MRGdSFS/PI4-ICA-IoT/outputs/renders/sit_hero.png

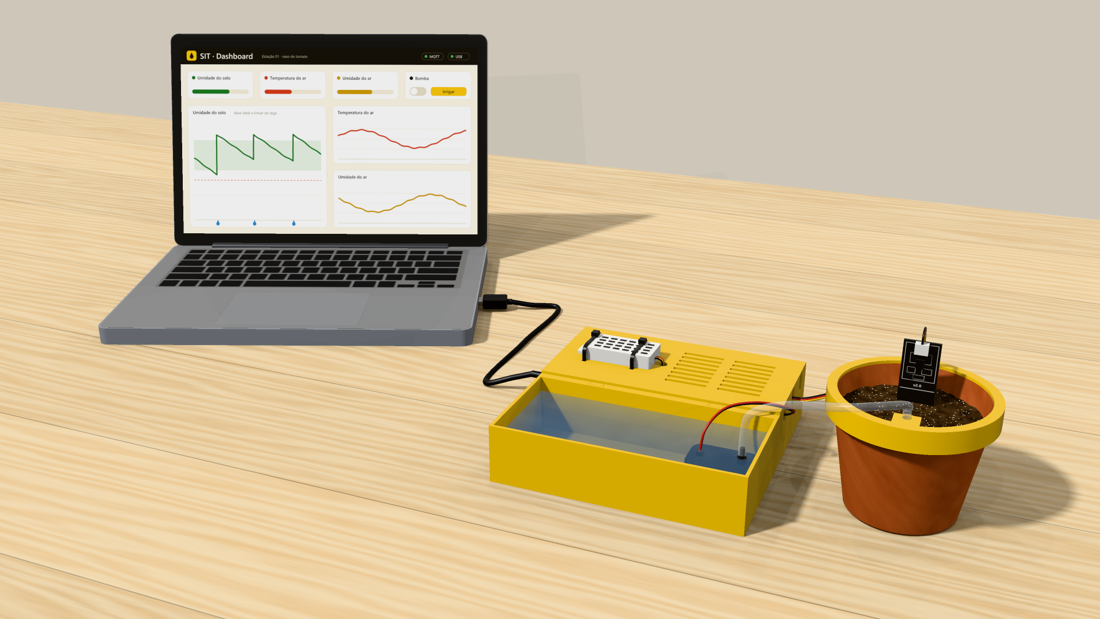
outputs/renders/sit_hero.png
