MRGdSFS/PI4-ICA-IoT/outputs/renders/sit_sobre_notebook.png

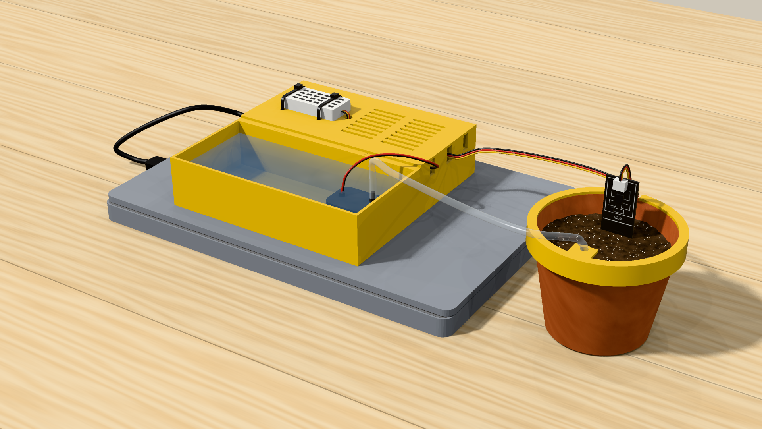
outputs/renders/sit_sobre_notebook.png
