MRGdSFS/PI4-ICA-IoT/codes/modelo3d/render/tex/dashboard.png

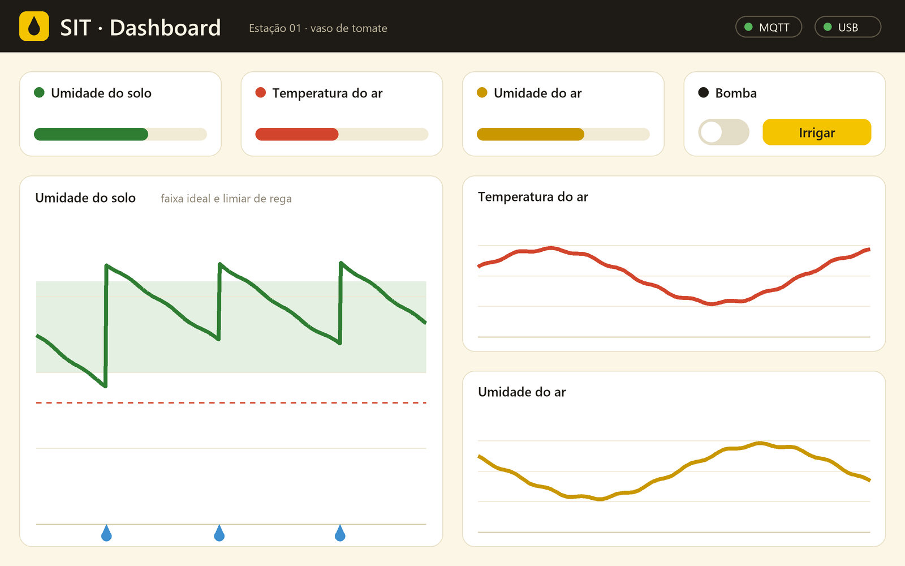
codes/modelo3d/render/tex/dashboard.png
