MRGdSFS/PI4-ICA-IoT/codes/modelo3d/render/tex/esp32_pcb.png

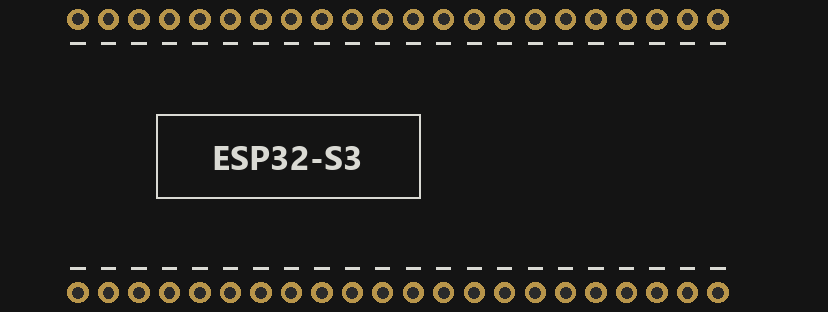
codes/modelo3d/render/tex/esp32_pcb.png
