MRGdSFS/PI4-ICA-IoT/codes/modelo3d/render/tex/protoboard.png

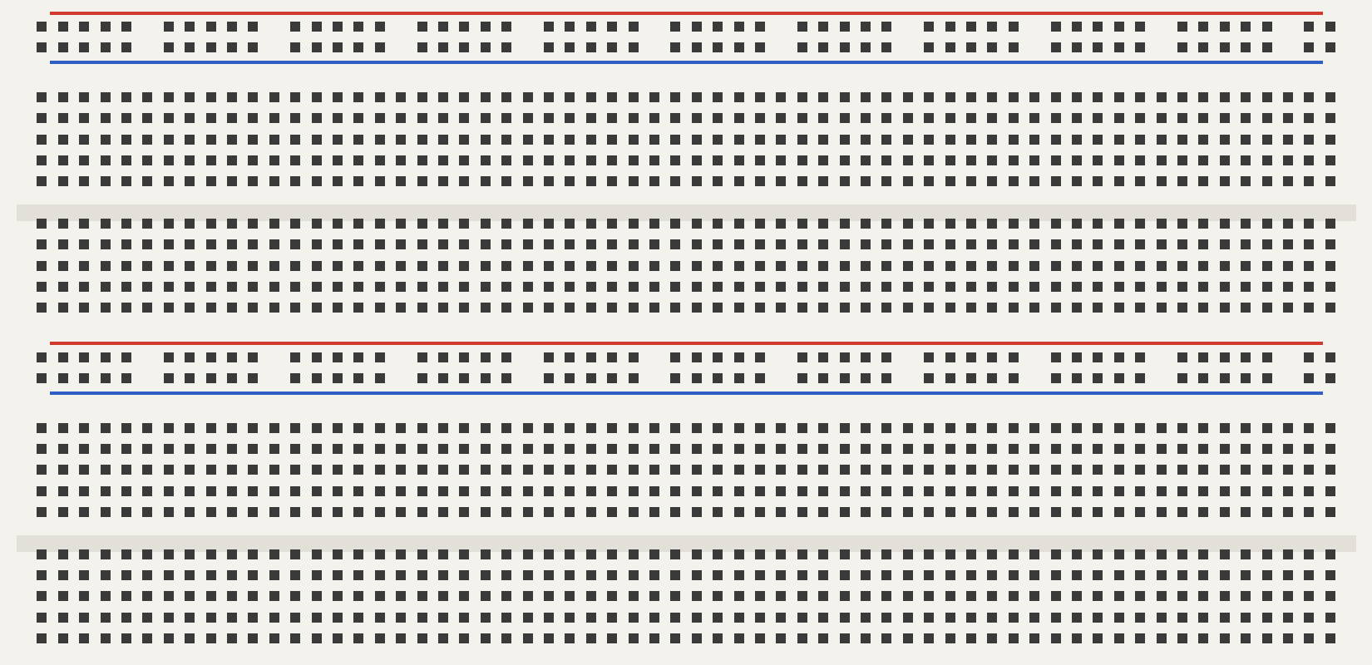
codes/modelo3d/render/tex/protoboard.png
