MRGdSFS/PI4-ICA-IoT/codes/modelo3d/render/tex/sensor_pcb.png

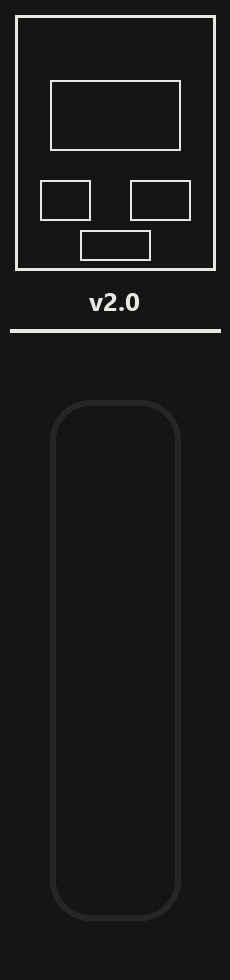
codes/modelo3d/render/tex/sensor_pcb.png
