MRGdSFS/PI4-ICA-IoT/codes/modelo3d/render/tex/teclado.png

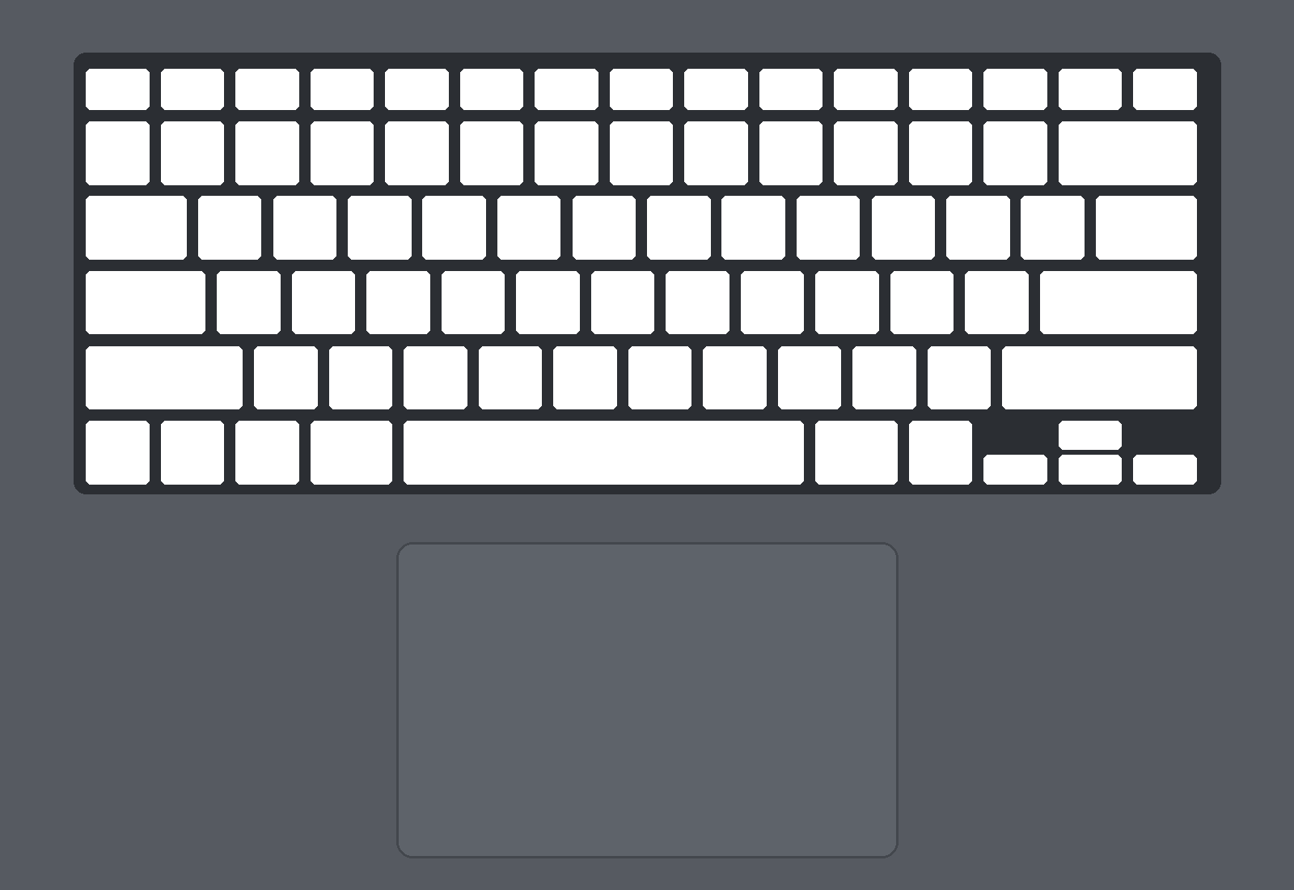
codes/modelo3d/render/tex/teclado.png
