MRGdSFS/PI4-ICA-IoT/outputs/coleta/comunicacao.png

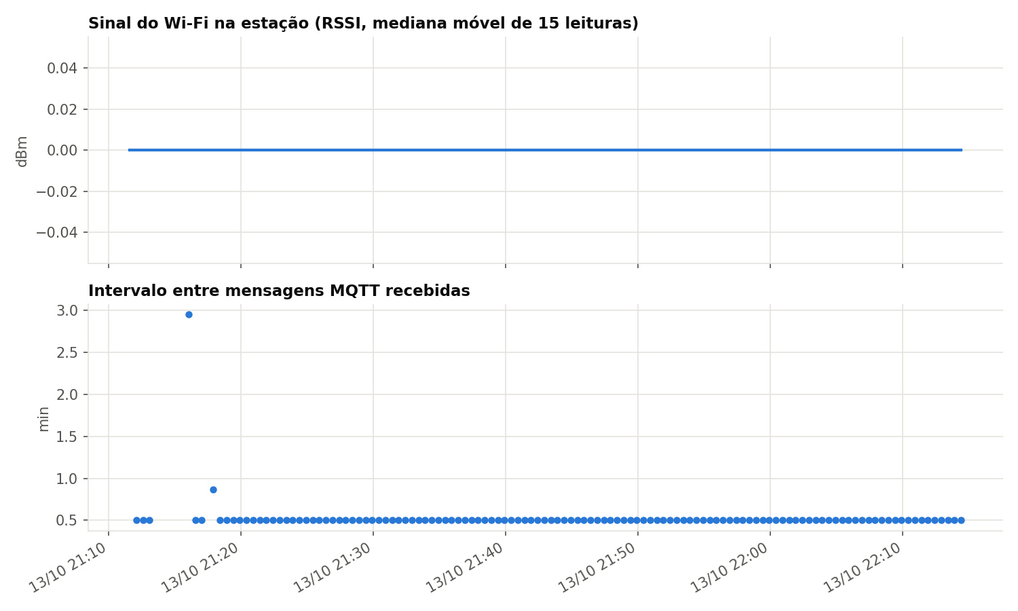
outputs/coleta/comunicacao.png
