MRGdSFS/PI4-ICA-IoT/outputs/coleta/serie_temporal.png

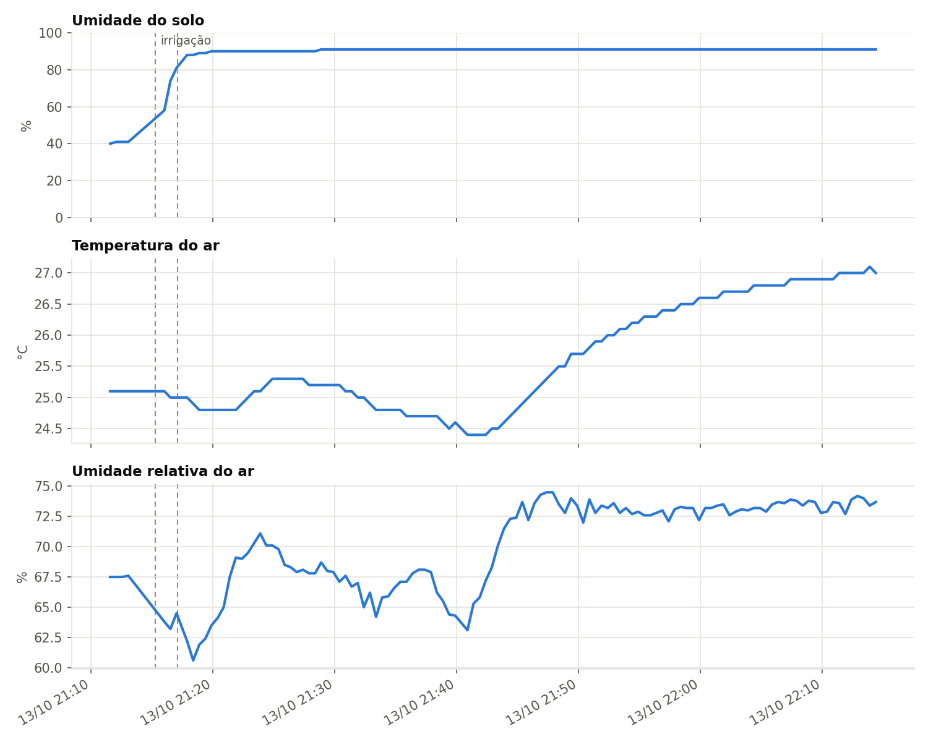
outputs/coleta/serie_temporal.png
