MRGdSFS/PI4-ICA-IoT/outputs/eda02/05_umidade_solo_linha_1_sensor_0fa420b6626076658c3c1763550aee8149c2be5dba876a84a1ebd24aeaa84a78.png

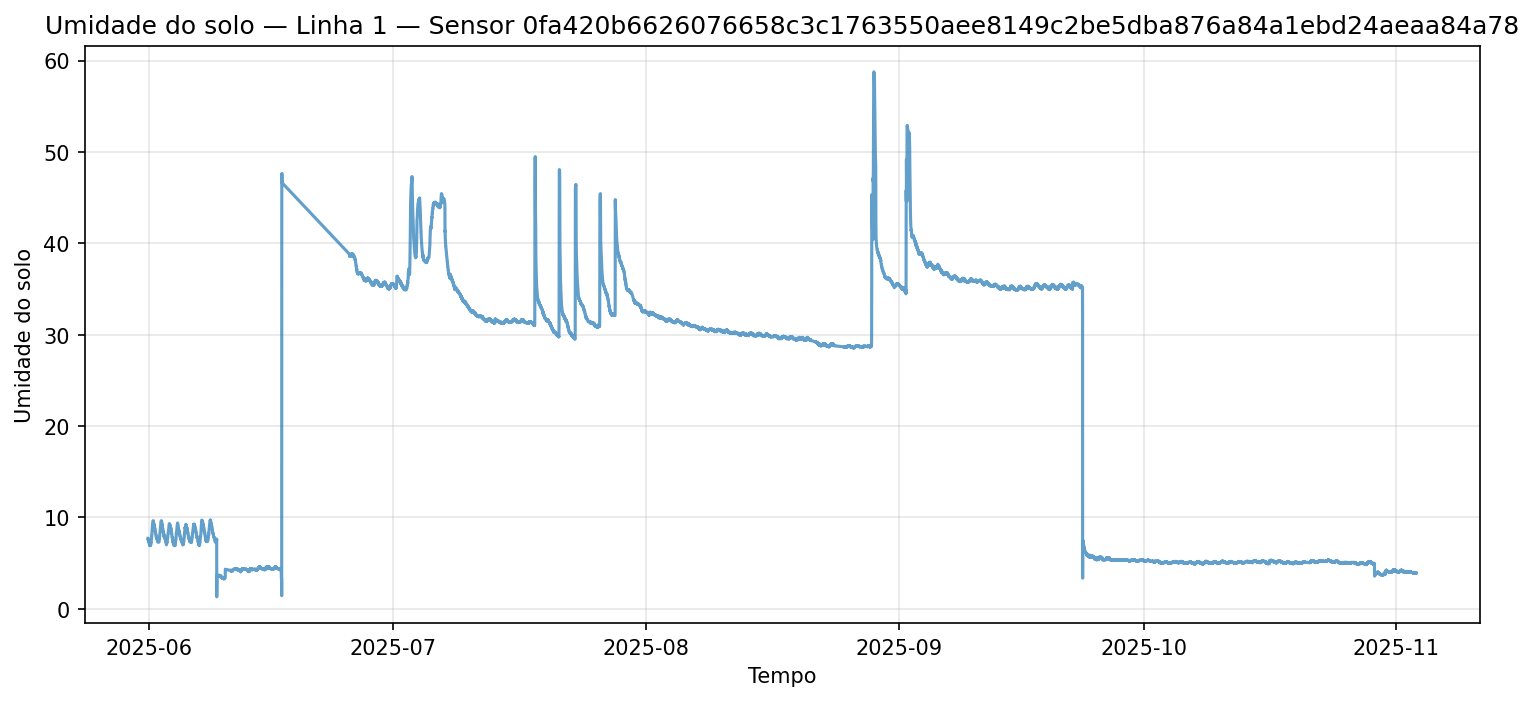
outputs/eda02/05_umidade_solo_linha_1_sensor_0fa420b6626076658c3c1763550aee8149c2be5dba876a84a1ebd24aeaa84a78.png
