MRGdSFS/PI4-ICA-IoT/outputs/eda02/05_umidade_solo_linha_2_sensor_908aff7e8767b6b3798e306c4d5568228e9360e32baf3c70aabee0a1d2c1670b.png

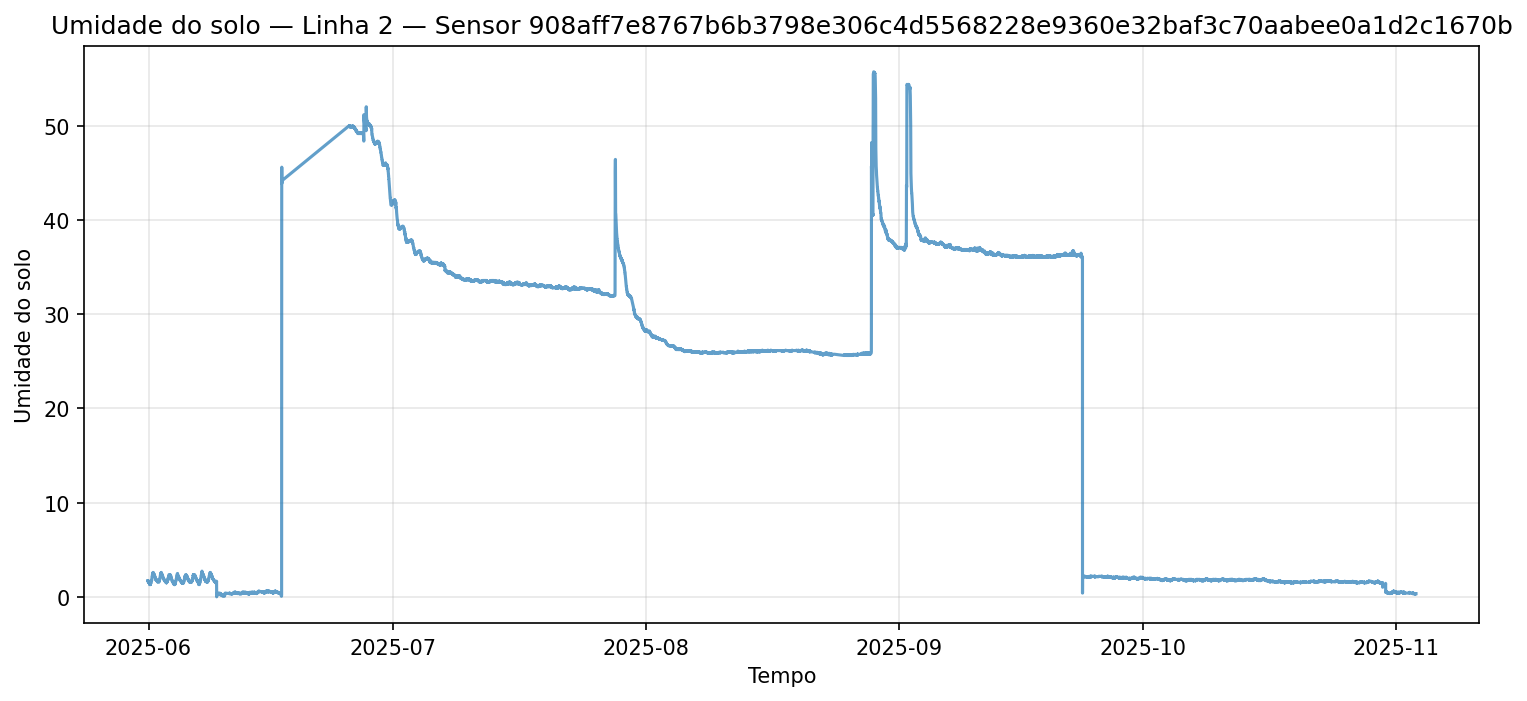
outputs/eda02/05_umidade_solo_linha_2_sensor_908aff7e8767b6b3798e306c4d5568228e9360e32baf3c70aabee0a1d2c1670b.png
