MRGdSFS/PI4-ICA-IoT/outputs/eda02/05_umidade_solo_linha_3_sensor_2f2ba968948ac82e9517eddb42fc1043d211d6da9f0725cd47ce2fb995701b92.png

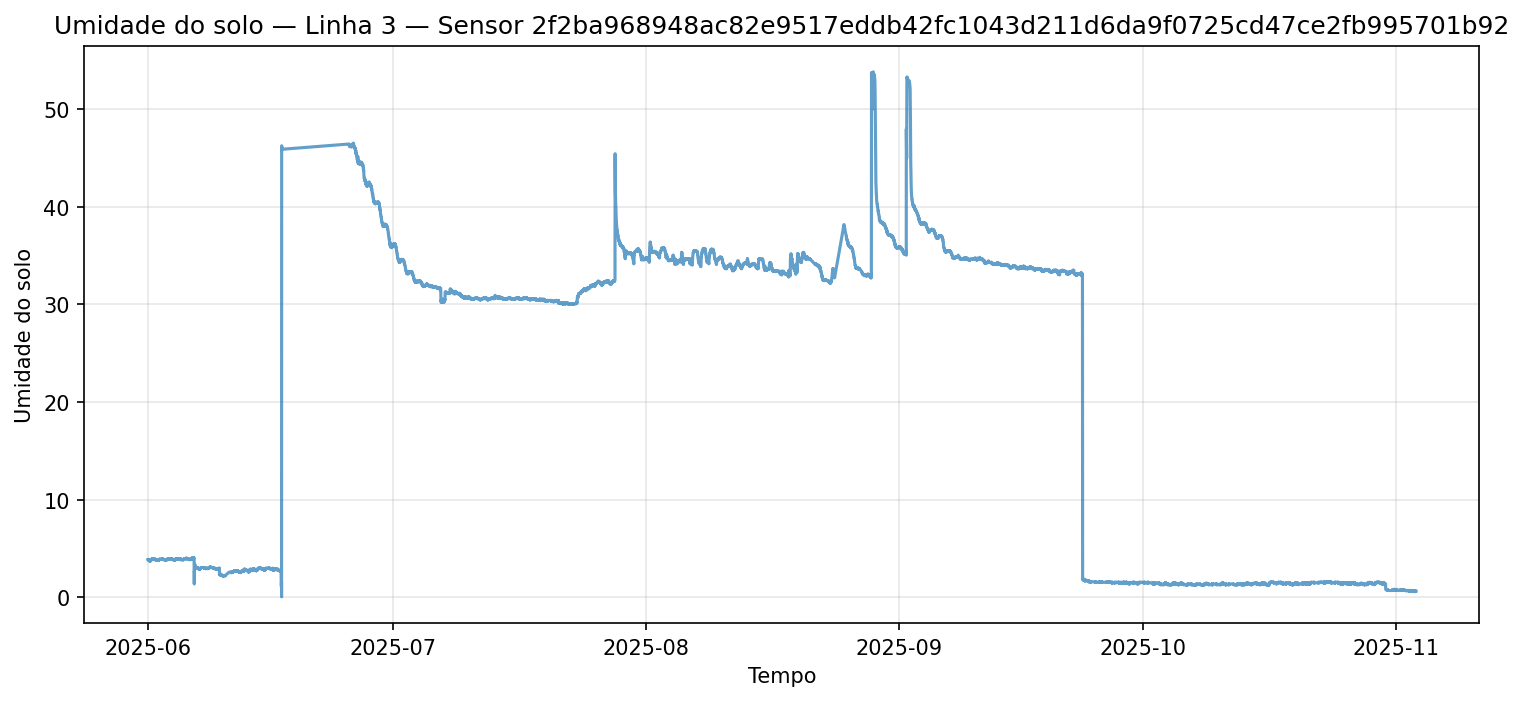
outputs/eda02/05_umidade_solo_linha_3_sensor_2f2ba968948ac82e9517eddb42fc1043d211d6da9f0725cd47ce2fb995701b92.png
