MRGdSFS/PI4-ICA-IoT/outputs/eda02/05_umidade_solo_linha_3_sensor_901b4b4b92f53023e62436410e7a000efb07750ba9bcb40327dd2a56a8259947.png

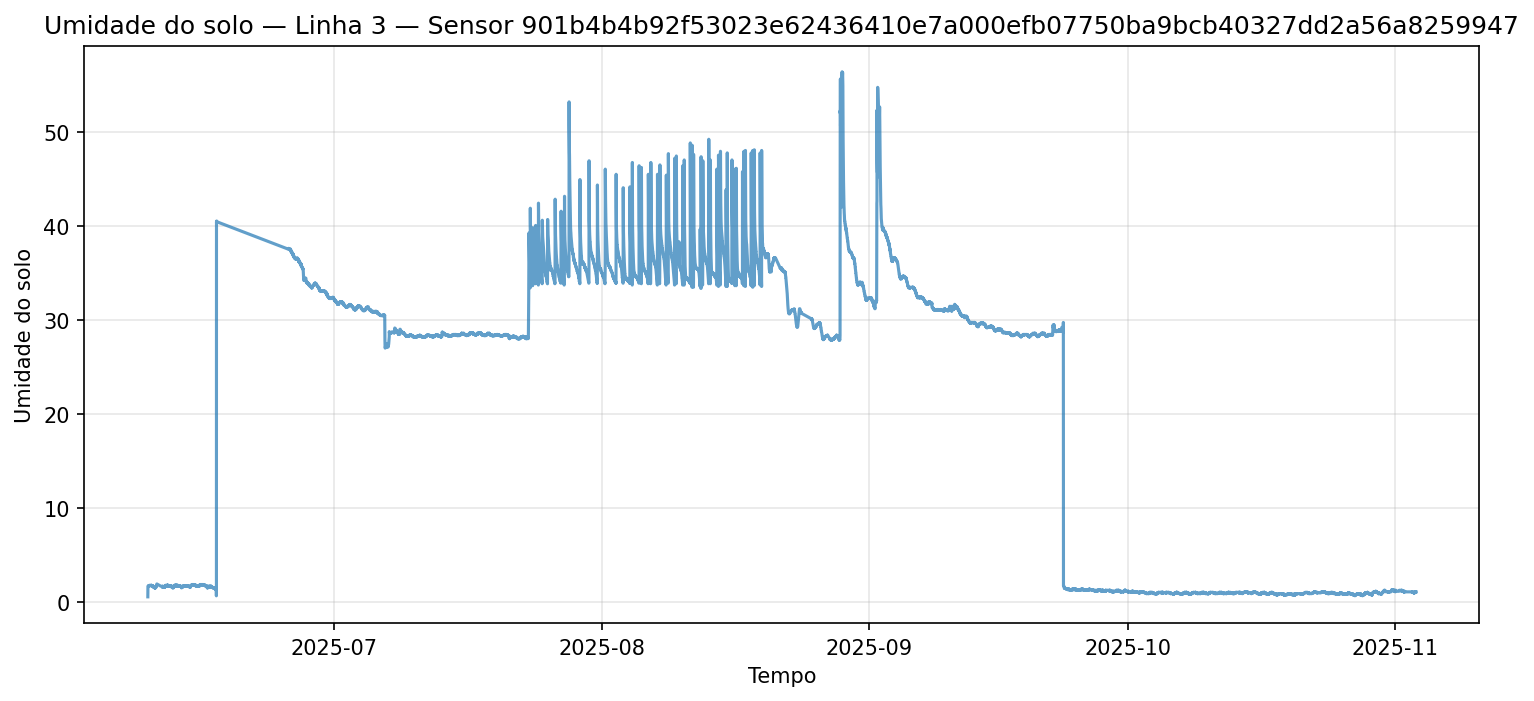
outputs/eda02/05_umidade_solo_linha_3_sensor_901b4b4b92f53023e62436410e7a000efb07750ba9bcb40327dd2a56a8259947.png
