MRGdSFS/PI4-ICA-IoT/outputs/eda02/05_umidade_solo_linha_4_sensor_1bc7a8260cd19c9c75aad0841fcd05fe378d0829876eaff4f28852379df87362.png

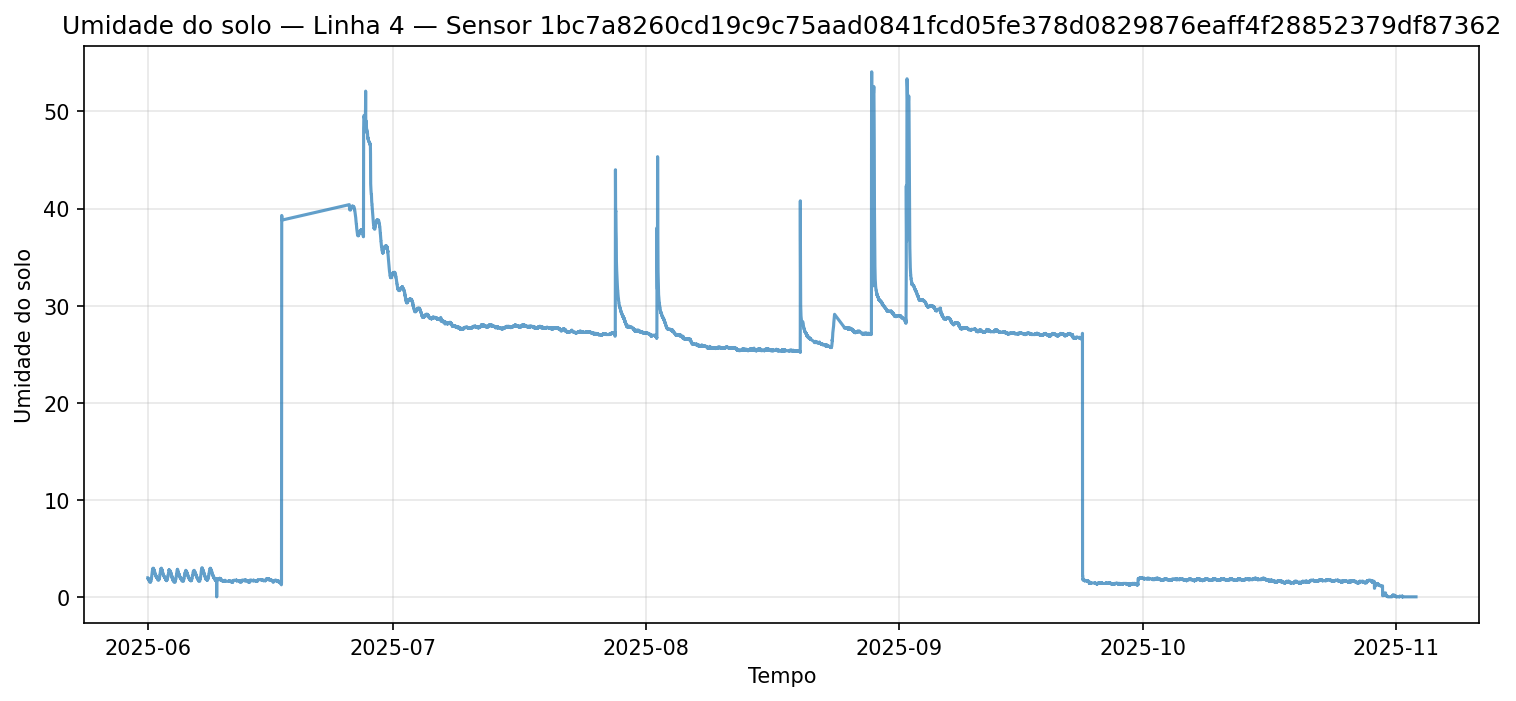
outputs/eda02/05_umidade_solo_linha_4_sensor_1bc7a8260cd19c9c75aad0841fcd05fe378d0829876eaff4f28852379df87362.png
