MRGdSFS/PI4-ICA-IoT/outputs/eda02/05_umidade_solo_linha_5_sensor_0da903b52deaa17da6387570c1ae38b6e5b83f564490c425d3ad917efb7377cf.png

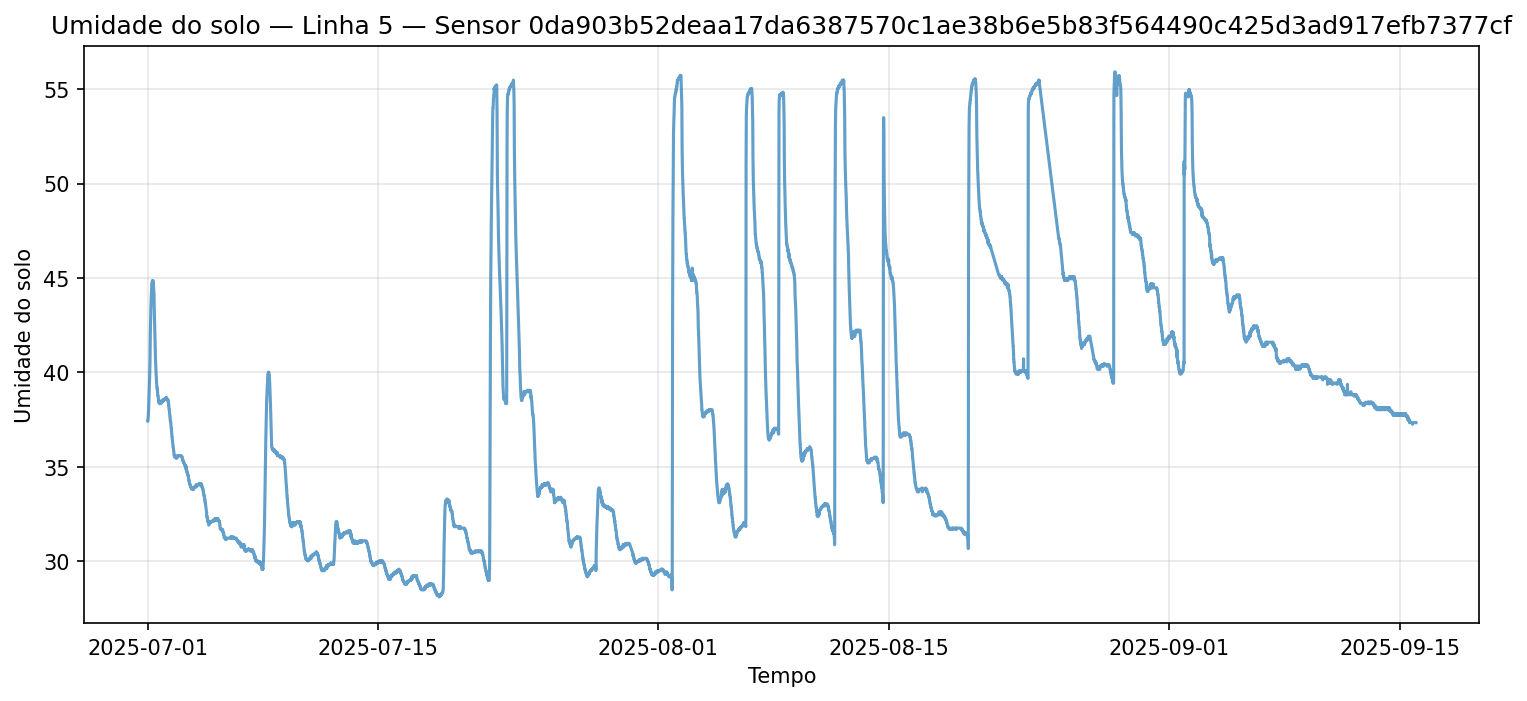
outputs/eda02/05_umidade_solo_linha_5_sensor_0da903b52deaa17da6387570c1ae38b6e5b83f564490c425d3ad917efb7377cf.png
