MRGdSFS/PI4-ICA-IoT/outputs/eda02/05_umidade_solo_linha_5_sensor_19b4d911bd3c758c263c5f29f8202bdd0174220c4d7d604b605ee7ed29287e50.png

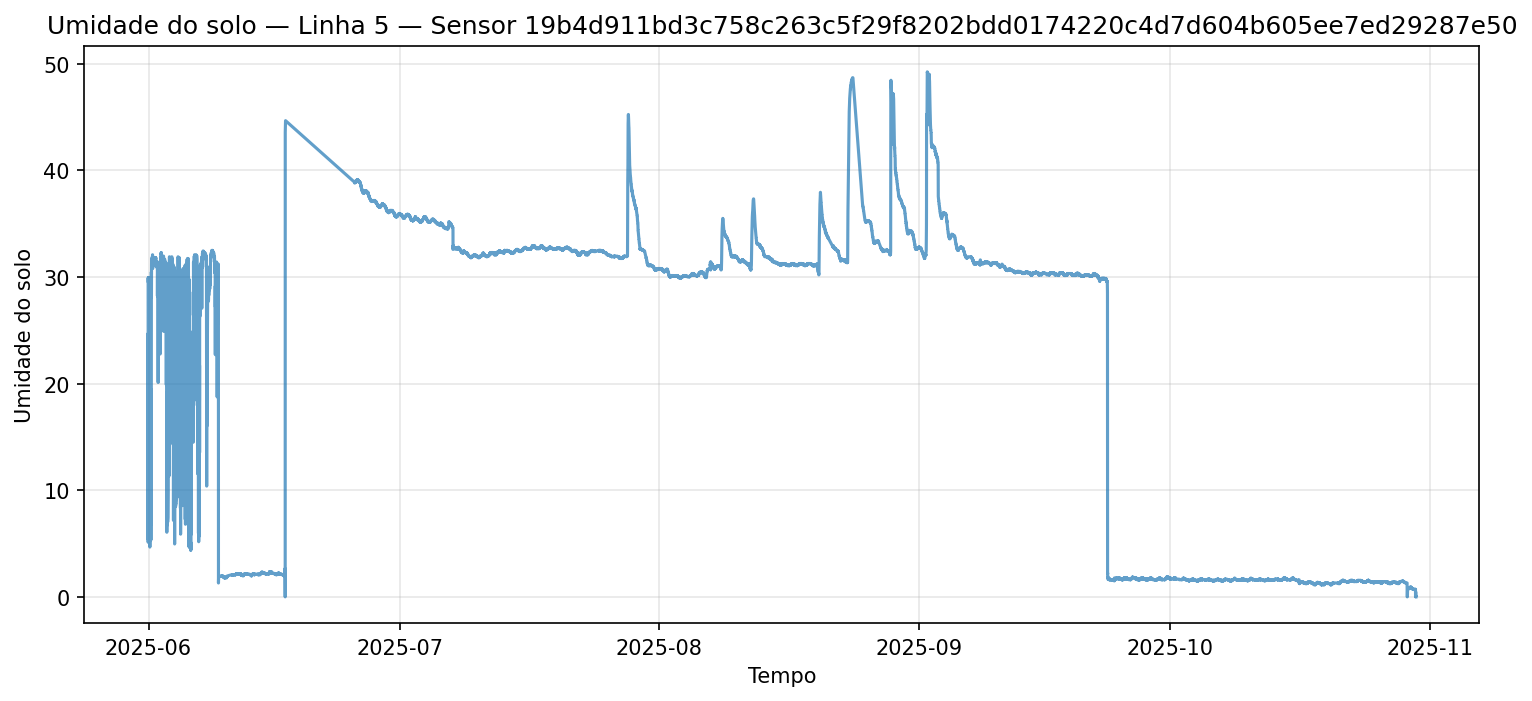
outputs/eda02/05_umidade_solo_linha_5_sensor_19b4d911bd3c758c263c5f29f8202bdd0174220c4d7d604b605ee7ed29287e50.png
