MRGdSFS/PI4-ICA-IoT/outputs/eda02/06_frequencia_sensor.png

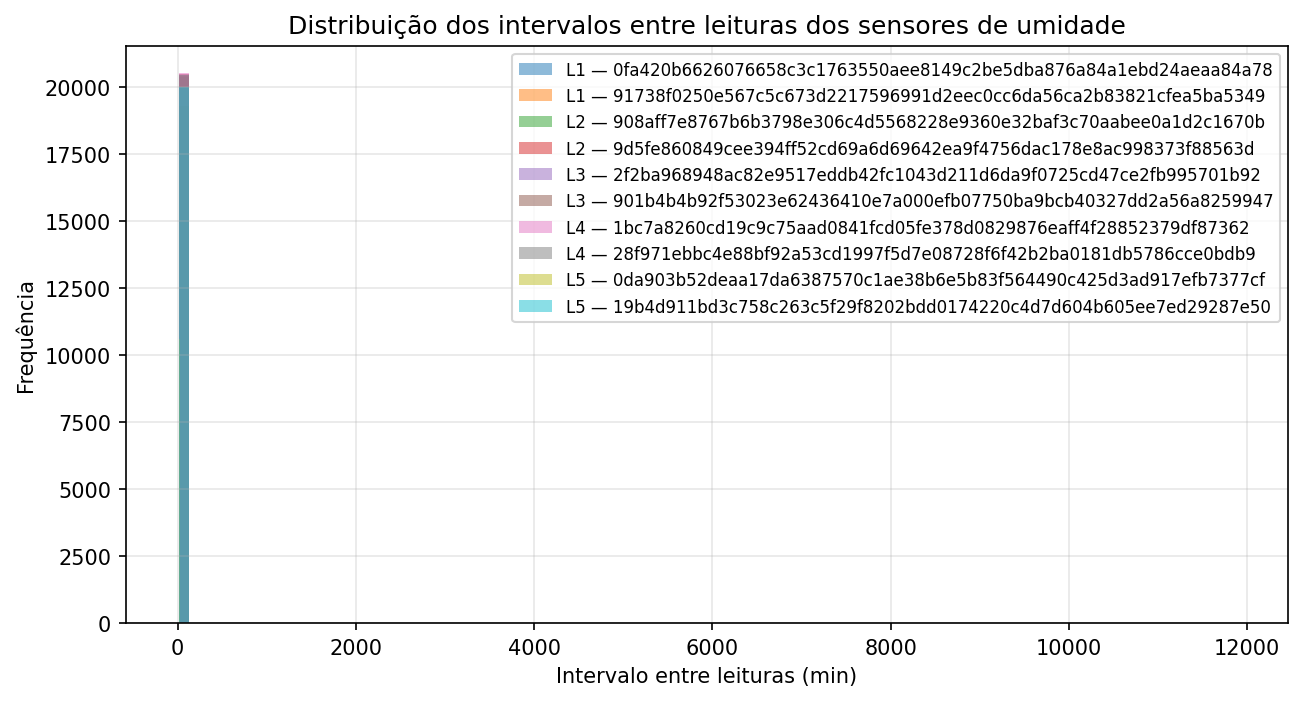
outputs/eda02/06_frequencia_sensor.png
