MRGdSFS/PI4-ICA-IoT/outputs/eda02/07_valvula_irrigacao.png

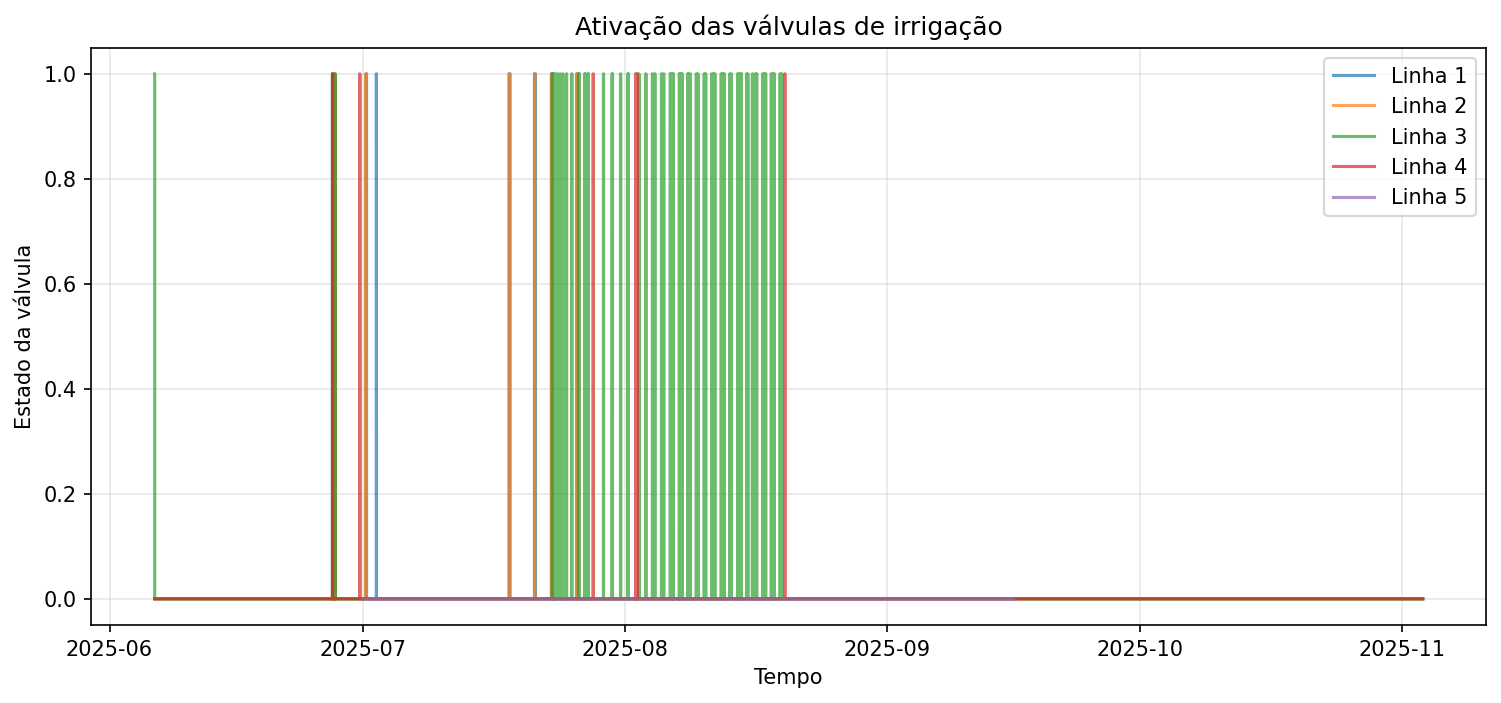
outputs/eda02/07_valvula_irrigacao.png
