MRGdSFS/PI4-ICA-IoT/outputs/eda02/08_resposta_umidade_irrigacao.png

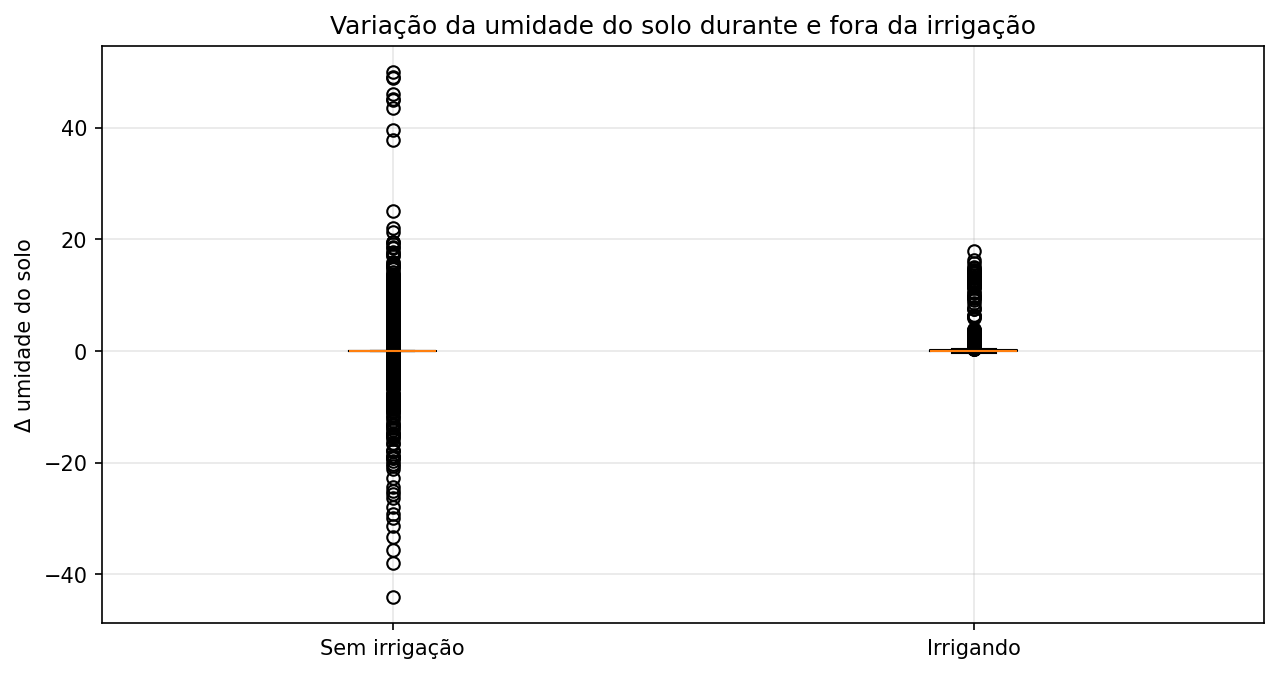
outputs/eda02/08_resposta_umidade_irrigacao.png
