MRGdSFS/PI4-ICA-IoT/outputs/eda02/09_padrao_diurno_linha_1_sensor_91738f0250e567c5c673d2217596991d2eec0cc6da56ca2b83821cfea5ba5349.png

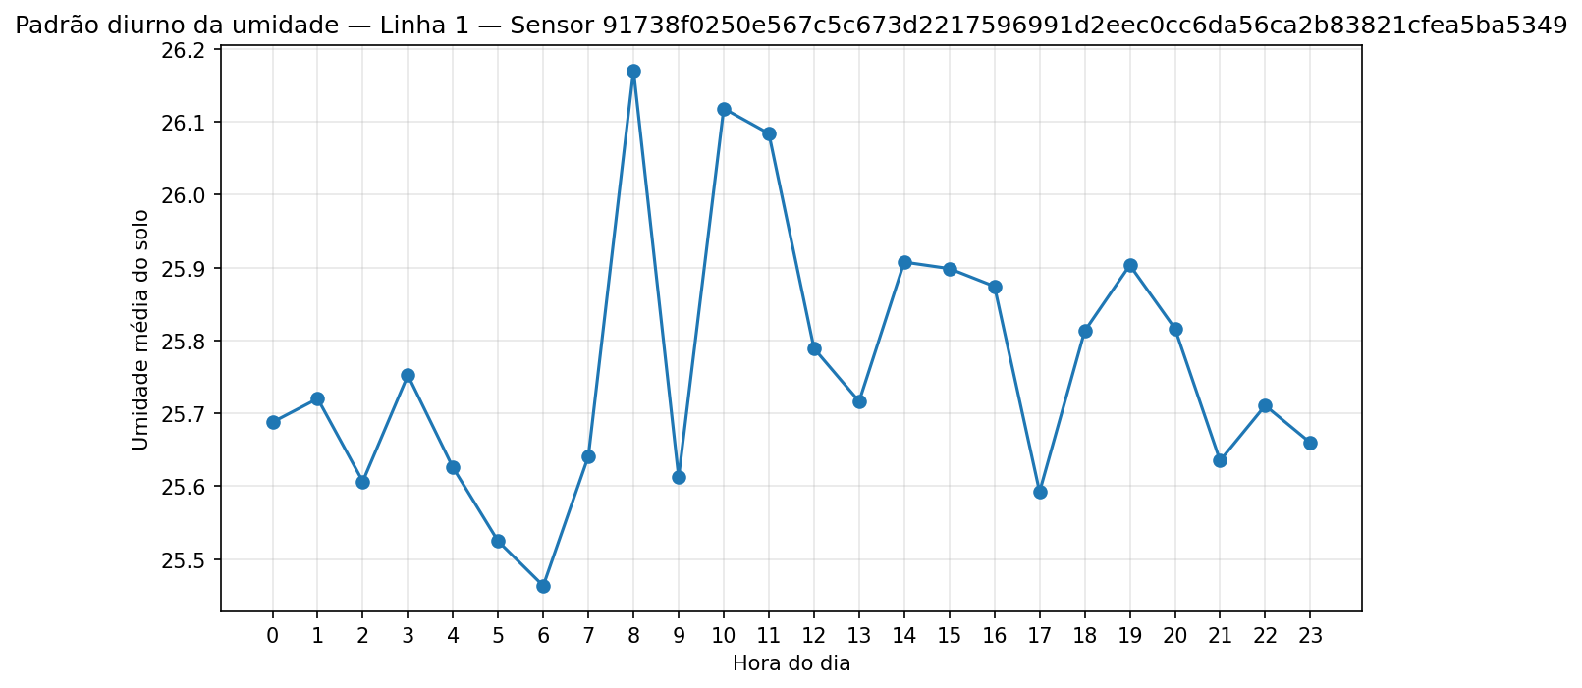
outputs/eda02/09_padrao_diurno_linha_1_sensor_91738f0250e567c5c673d2217596991d2eec0cc6da56ca2b83821cfea5ba5349.png
