MRGdSFS/PI4-ICA-IoT/outputs/eda02/09_padrao_diurno_linha_2_sensor_9d5fe860849cee394ff52cd69a6d69642ea9f4756dac178e8ac998373f88563d.png

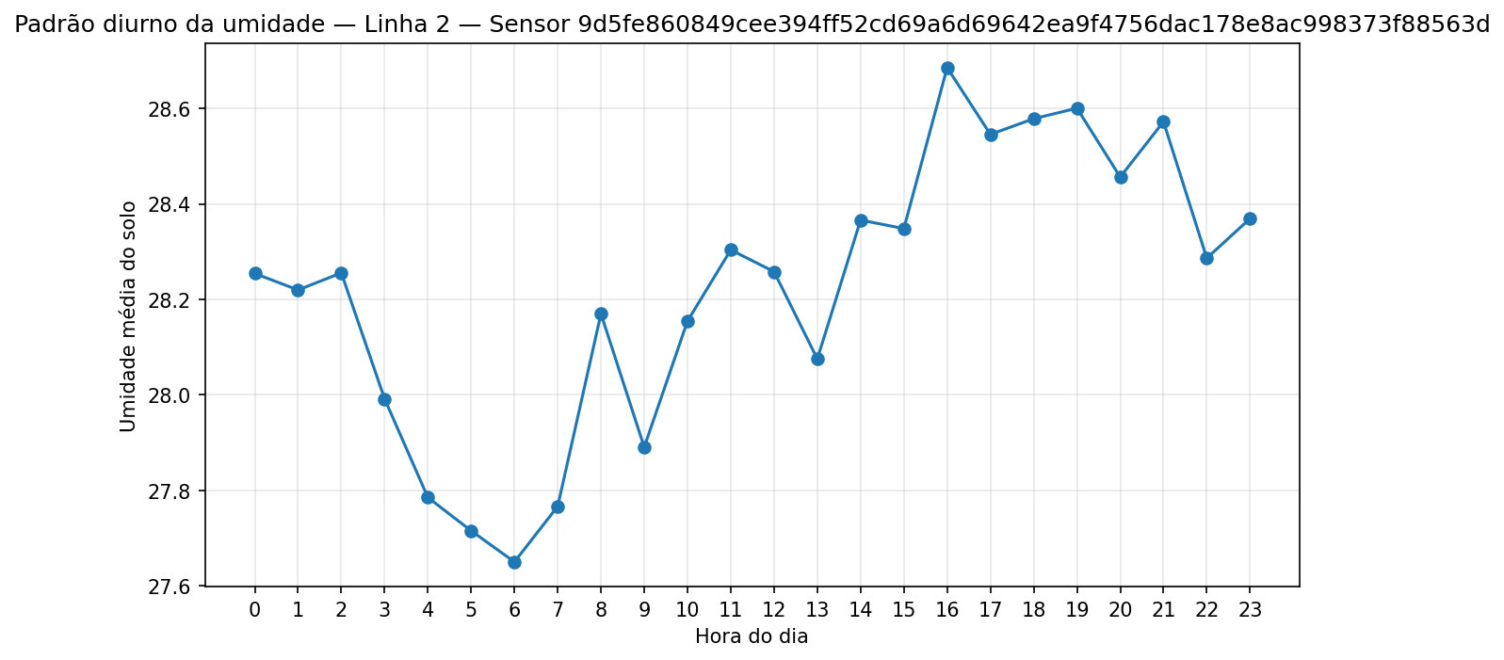
outputs/eda02/09_padrao_diurno_linha_2_sensor_9d5fe860849cee394ff52cd69a6d69642ea9f4756dac178e8ac998373f88563d.png
