MRGdSFS/PI4-ICA-IoT/outputs/eda02/09_padrao_diurno_linha_4_sensor_28f971ebbc4e88bf92a53cd1997f5d7e08728f6f42b2ba0181db5786cce0bdb9.png

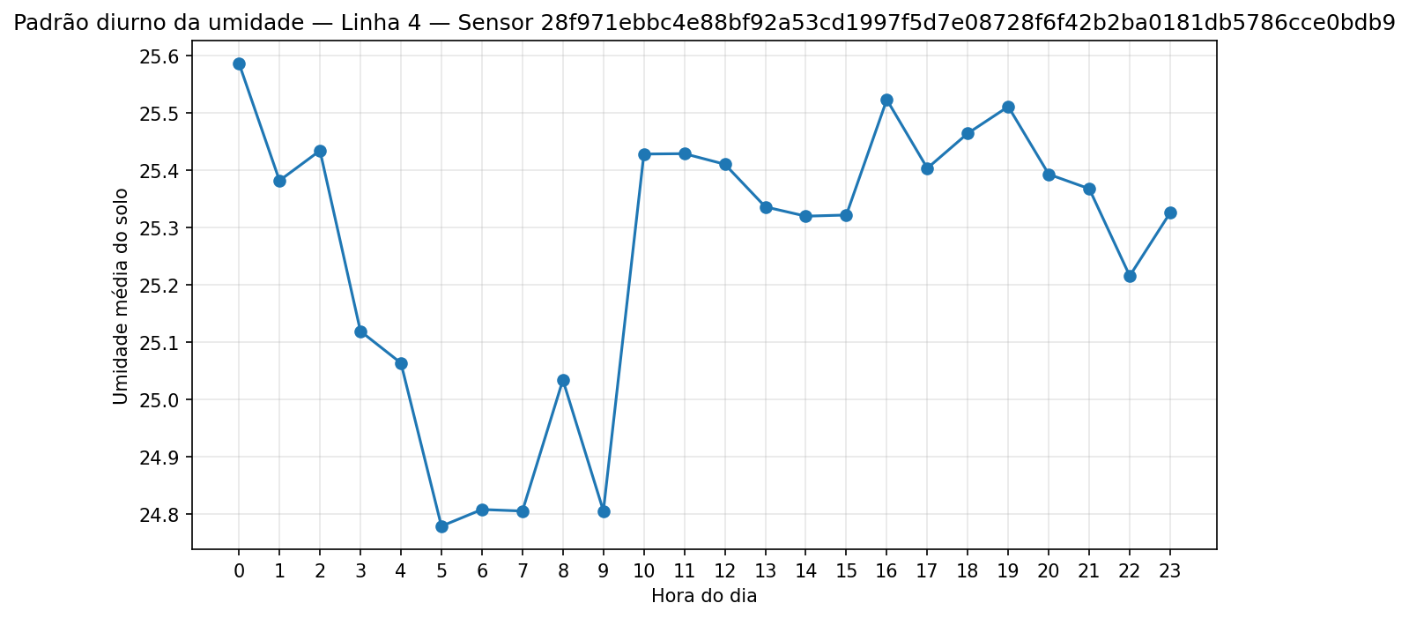
outputs/eda02/09_padrao_diurno_linha_4_sensor_28f971ebbc4e88bf92a53cd1997f5d7e08728f6f42b2ba0181db5786cce0bdb9.png
