MRGdSFS/PI4-ICA-IoT/outputs/eda02/10_temperatura_vs_delta_umidade.png

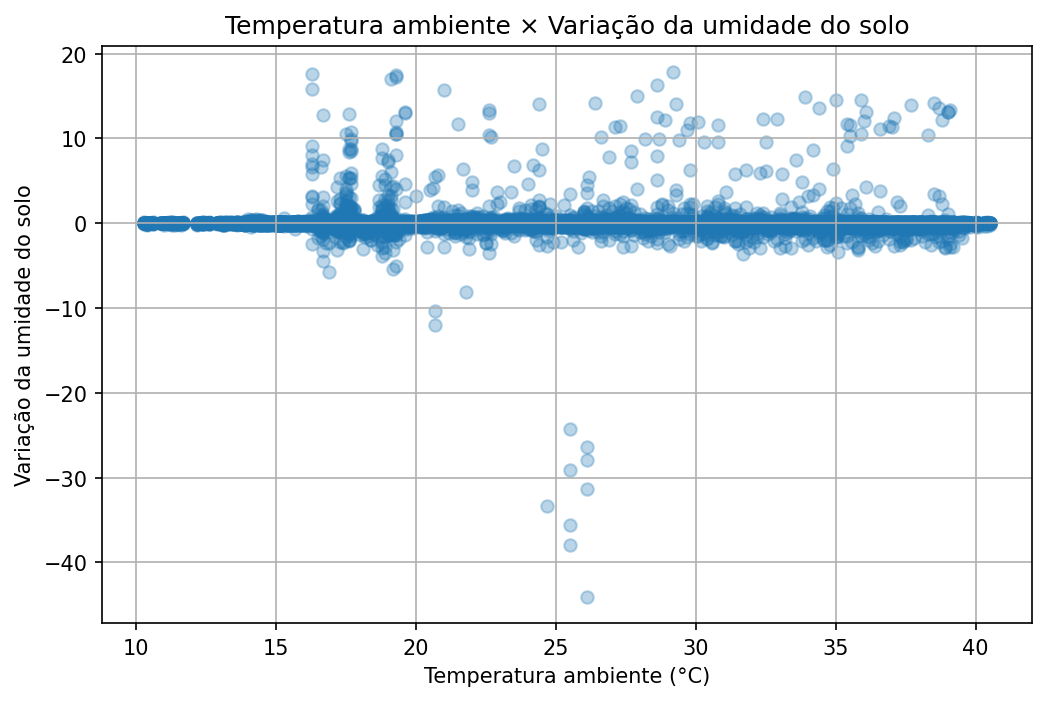
outputs/eda02/10_temperatura_vs_delta_umidade.png
