MRGdSFS/PI4-ICA-IoT/outputs/eda02/12_umidade_por_linha.png

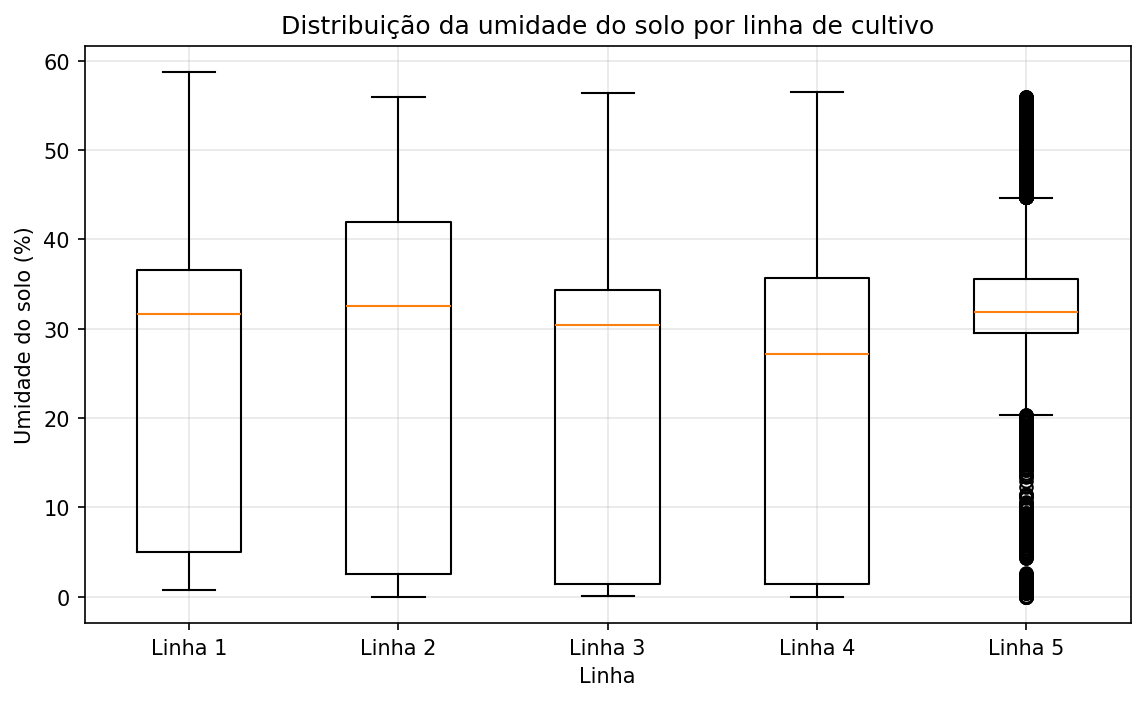
outputs/eda02/12_umidade_por_linha.png
