MRGdSFS/PI4-ICA-IoT/outputs/modelo3d/preview_pecas.png

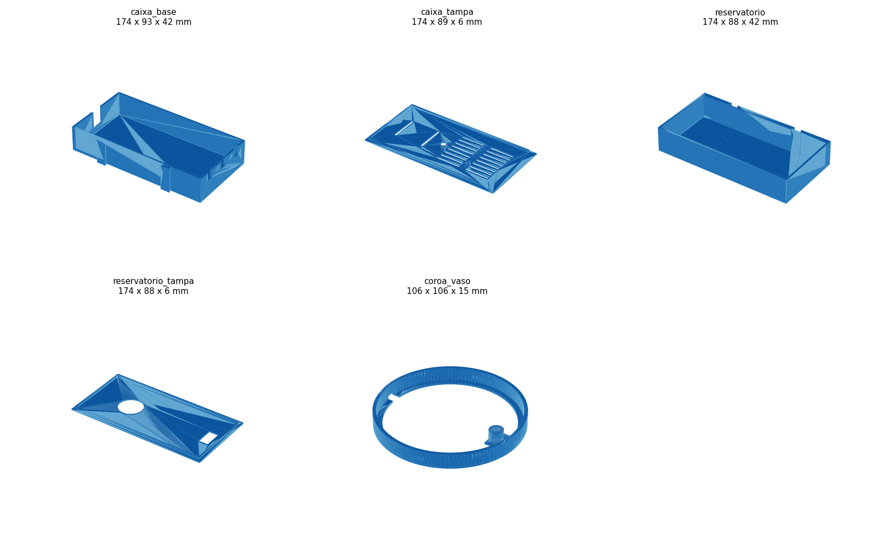
outputs/modelo3d/preview_pecas.png
