MRGdSFS/PI4-ICA-IoT/outputs/renders/dashboard_preview.png

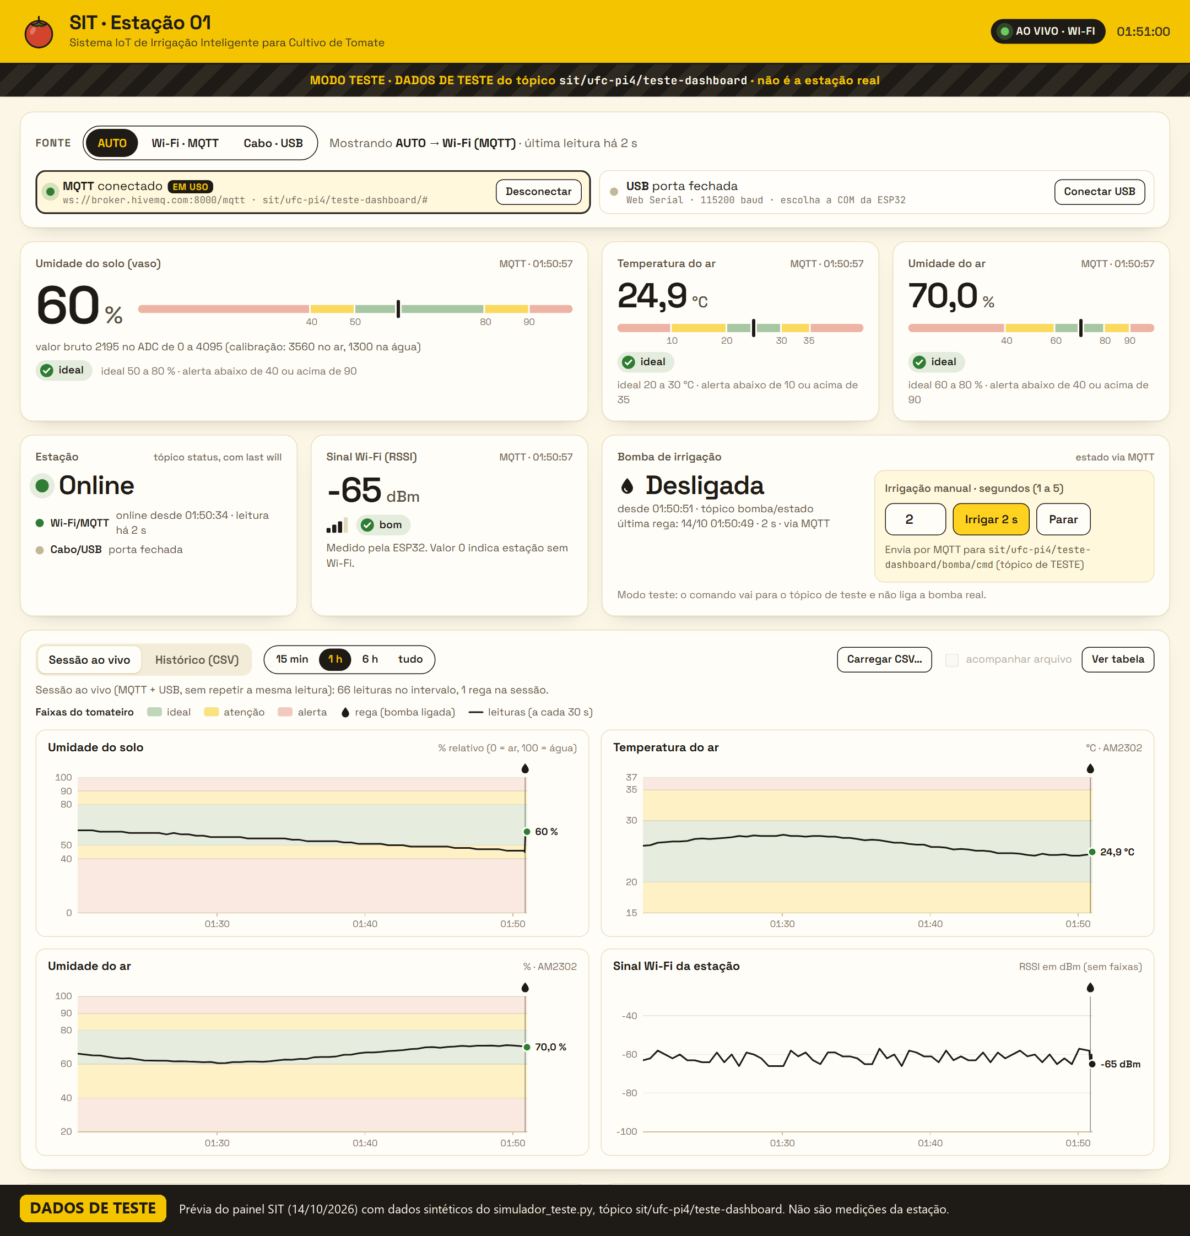
outputs/renders/dashboard_preview.png
