MRGdSFS/PI4-ICA-IoT/outputs/renders/dashboard_preview_mqtt.png

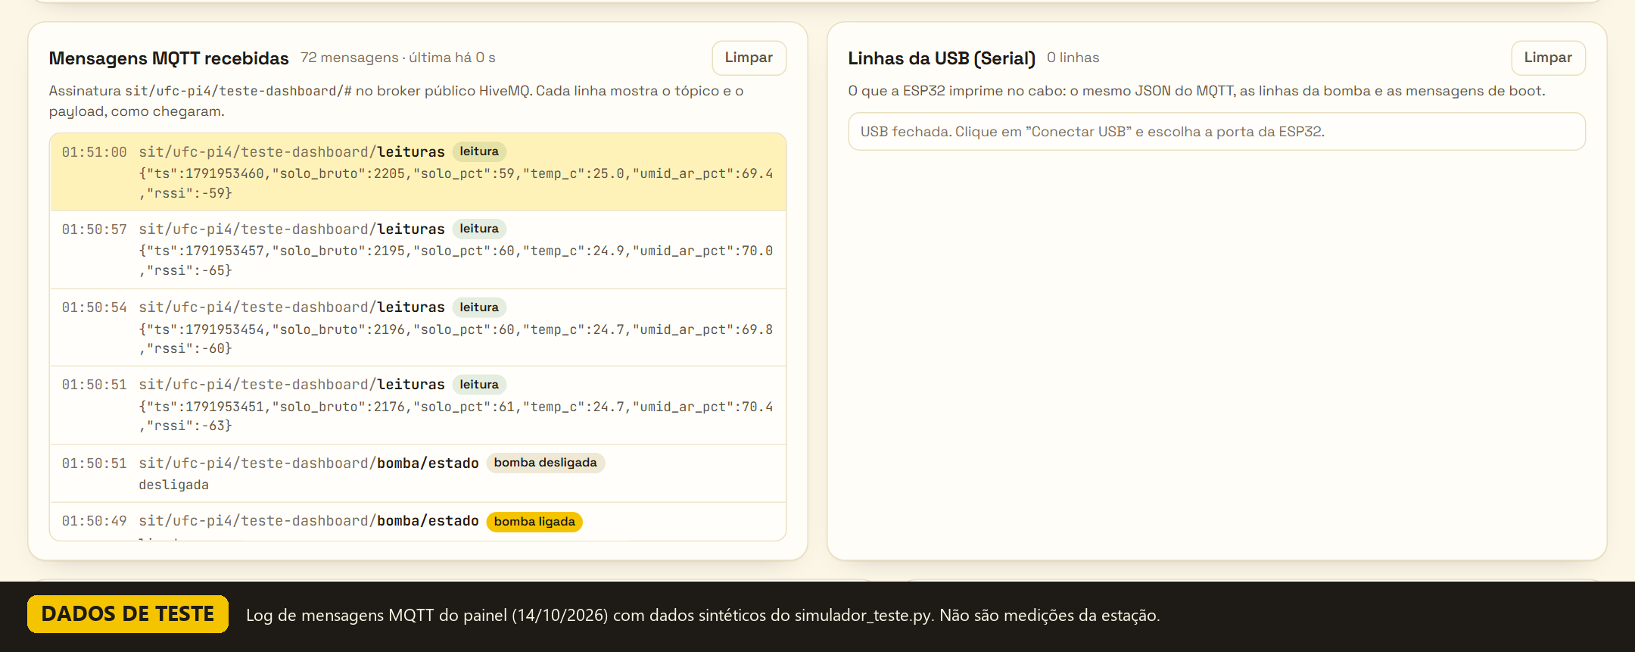
outputs/renders/dashboard_preview_mqtt.png
