MRGdSFS/PI4-ICA-IoT/outputs/renders/sit_estacao_closeup.png

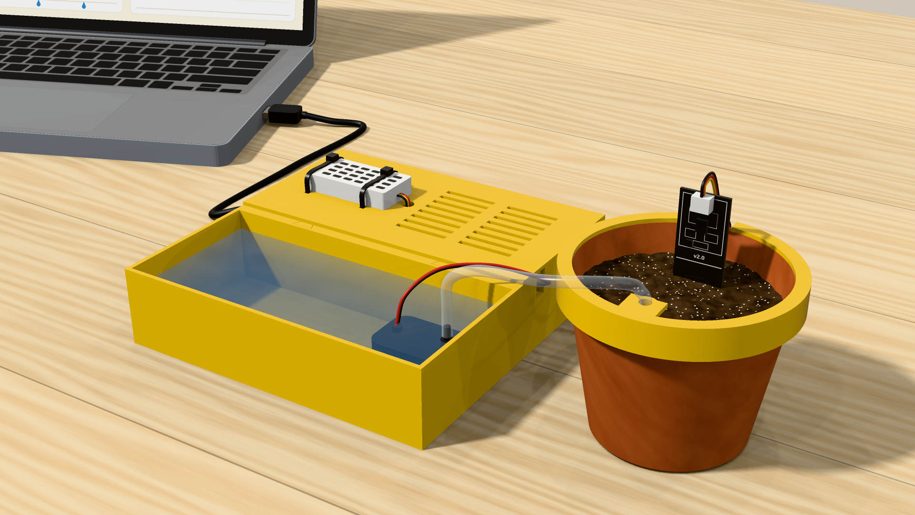
outputs/renders/sit_estacao_closeup.png
