MRGdSFS/PI4-ICA-IoT/outputs/renders/sit_explodida.png

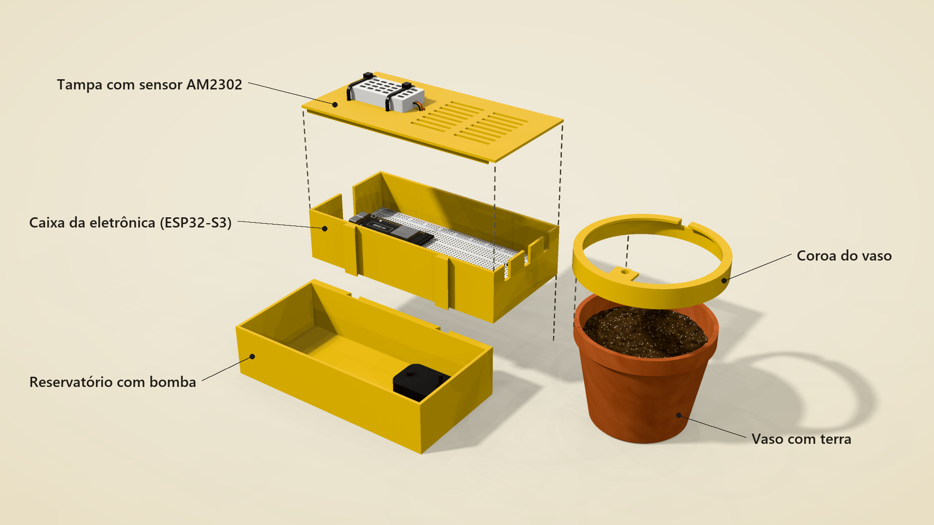
outputs/renders/sit_explodida.png
