MRGdSFS/PI4-ICA-IoT/outputs/renders/sit_interno.png

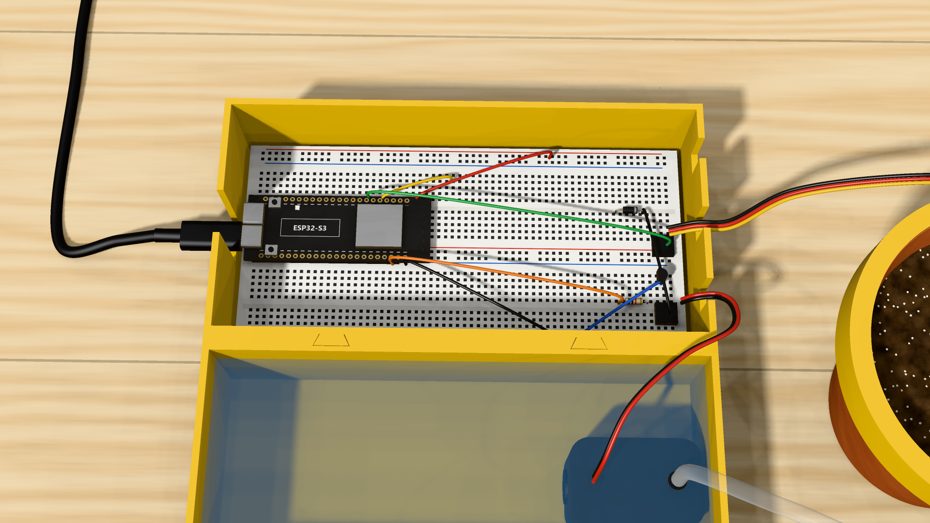
outputs/renders/sit_interno.png
