MRGdSFS/PI4-ICA-IoT/outputs/modelo3d/caixa_base.stl

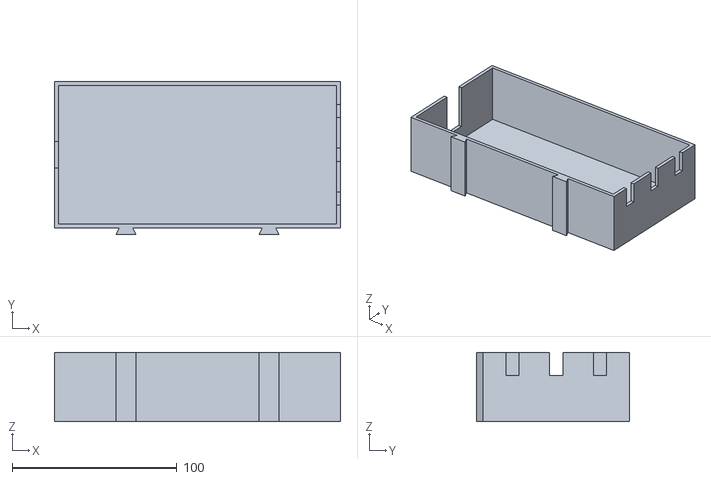
[picture p48: CAD file, 2026-10-14]
outputs/modelo3d/caixa_base.stl
173.8 x 92.8 x 42.0
