MRGdSFS/PI4-ICA-IoT/outputs/modelo3d/reservatorio_tampa.stl

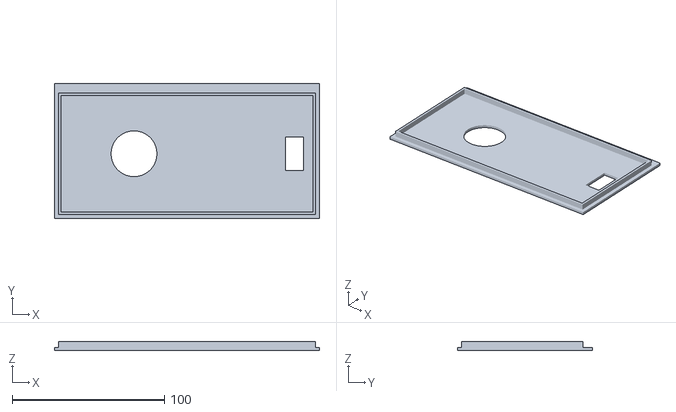
[picture p49: CAD file, 2026-10-14]
outputs/modelo3d/reservatorio_tampa.stl
173.8 x 88.4 x 6.00
