MRGdSFS/PI4-ICA-IoT/outputs/modelo3d/reservatorio.stl

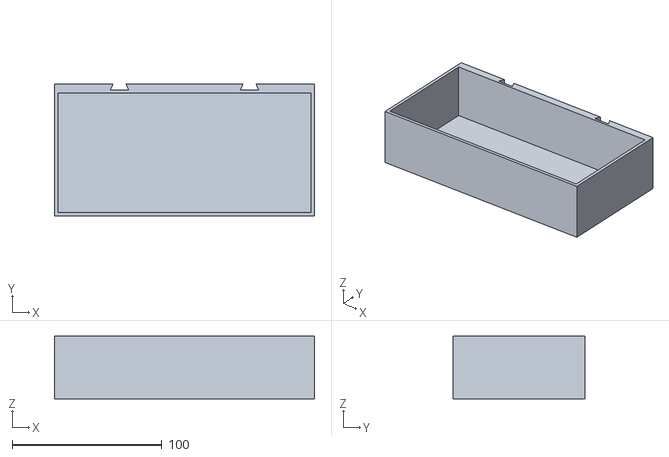
[picture p50: CAD file, 2026-10-14]
outputs/modelo3d/reservatorio.stl
173.8 x 88.4 x 42.0
