MRGdSFS/PI4-ICA-IoT/outputs/modelo3d/caixa_tampa.stl

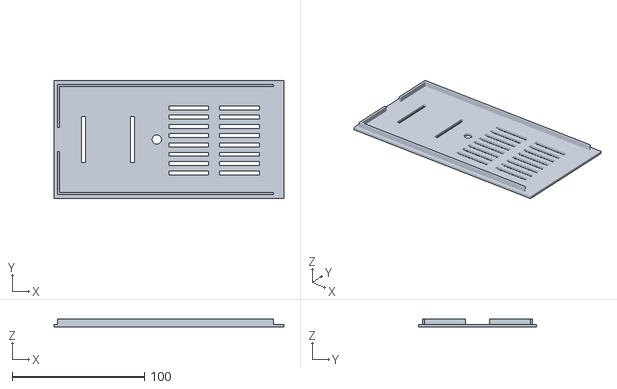
[picture p51: CAD file, 2026-10-14]
outputs/modelo3d/caixa_tampa.stl
173.8 x 88.8 x 6.00
