MRGdSFS/PI4-ICA-IoT/outputs/modelo3d/coroa_vaso.stl

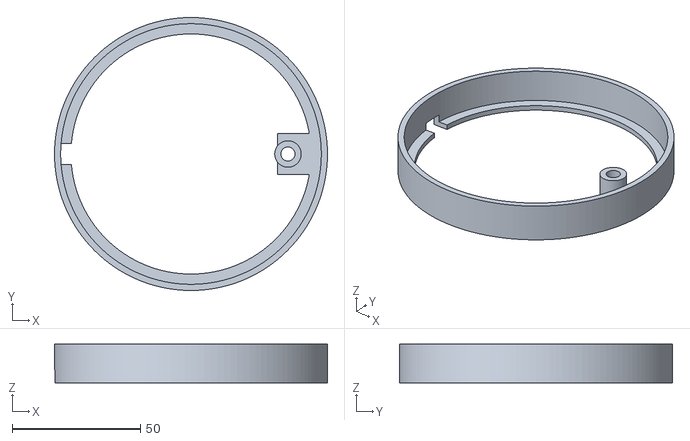
[picture p52: CAD file, 2026-10-14]
outputs/modelo3d/coroa_vaso.stl
106.3 x 106.3 x 15.0
