MRGdSFS/PI4-ICA-IoT/(commit log)

2026-09-02 Esboço para apresentação em cadeira de IoT
2026-09-02 Transferência do documento para nova subpasta
2026-09-02 Esboço do primeiro entregável de IoT
2026-09-02 Rename docs/v0 - Descrição Informal Projeto - Entrega 1.docx to docs/prof's docs/v0 - Descrição Informal Projeto - Entrega 1.docx
2026-09-02 Referências de projetos semelhantes (tem mais por vir)
2026-09-03 Correção do nome para compatibilidade com Windows
2026-09-03 Adicionado acesso ao editável do documento de entrega 1
2026-09-03 Correção de papers corrompidos + adição de link com notebook de pesquisa
2026-09-14 Correções bobas para manter arquivos .pdf e .txt corretos
2026-09-14 Códigos iniciais de análise exploratória + seus outputs
2026-09-14 Inclusão dos .csv dos outputs de eda + docs de relatório resumindo as duas etapas atuais de análise exploratória
    [02_resumo_temporal.csv, 03_serie_temporal_integrada.csv, 04_qualidade_dados_relevantes.csv, 05_estatisticas_umidade_por_linha.csv, 06_frequencia_sensor.csv, 06_maiores_variacoes_umidade.csv, 06_taxa_secagem_solo.csv, 07_eventos_irrigacao.csv]
2026-09-15 Refeita análise de secagem diferenciando sensores + modularização maior das funções empregadas na EDA02
    [06_frequencia_sensor.csv, 06_maiores_variacoes_umidade.csv, 06_taxa_secagem_solo.csv]
2026-09-21 Atualizações até dia 21 de Setembroo! Mudanças em EDA02 e seus Outputs, além de novo docs
    [02_resumo_temporal.csv, 03_serie_temporal_integrada.csv, 04_qualidade_dados_relevantes.csv, 04_qualidade_sensores_solo.csv, 05_estatisticas_umidade_por_linha.csv, 05_estatisticas_umidade_por_sensor.csv, 06_variacoes_umidade.csv, 07_eventos_irrigacao.csv]
2026-10-14 Entrega v1: firmware, coleta, dashboard, modelo 3D e docs
    [caixa_base.stl, caixa_tampa.stl, coroa_vaso.stl, eventos.csv, leituras.csv, reservatorio.stl, reservatorio_tampa.stl]
2026-11-08 Atualizações para o entregável v2 de IoT e M3 de PI IV, englobando o notebook de análise de dados e o cabeçalho do notebook do modelo
    [05_estatisticas_umidade_geral.csv, era5_fortaleza.csv, era5_parma.csv, linha3_10min.csv]
2026-11-09 Modelo: regressão logística para decidir quando regar
